shadowpho/SmartBattery/pSpice/DESIGN1.png

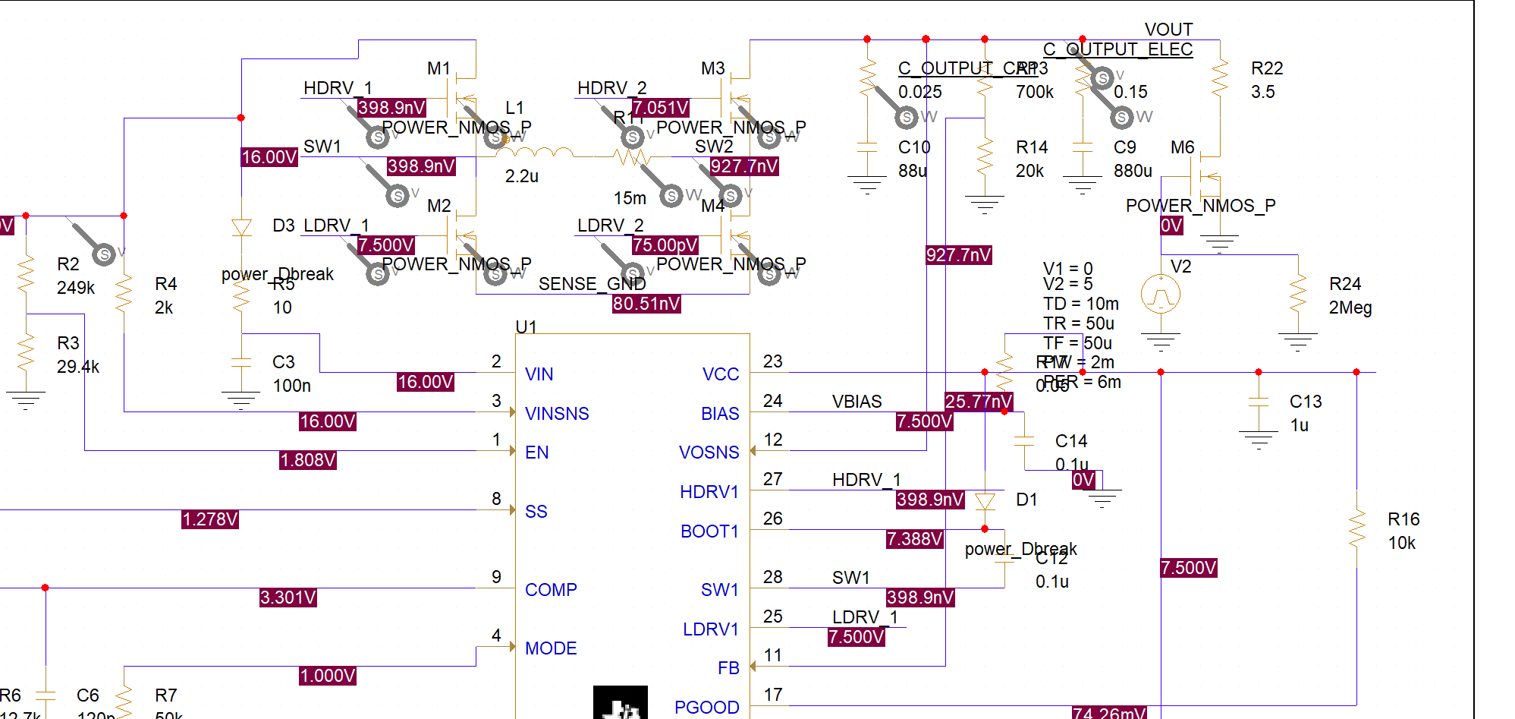
pSpice/DESIGN1.png
