shadowpho/SmartBattery/Cost_JLC3.xlsx

Comment | Designator | Footprint | LCSC
0.1uF 6.3v | C1,C6,C34 | lc_lib:0402_C | C1525
10u | C2,C3,C4,C7,C8,C9,C10,C11,C65,C66,C82,C83,C84,C85,C103,C112,C113 | lc_lib:0805_C | C15850
DNP | C12 | lc_lib:0402_C
1uF 25v | C13,C86,C97,C98,C99,C100,C101,C102,C106,C107,C108,C109,C110,C111,C114,C115 | lc_lib:0402_C | C52923
220u | C16,C40,C89 | Capacitor_SMD:C_Elec_8x10.2 | C311611
0.1u 6.3v | C18,C19,C20,C21,C23,C24,C25,C26,C32,C53,C54,C57,C59,C61,C62,C69,C72,C73,C74,C75 | lc_lib:0402_C | C1525
0.1u 20v | C27,C28 | lc_lib:0402_C | C1525
0.1u 50v | C30,C33 | lc_lib:0402_C | C1525
0.1uF | C31 | lc_lib:0402_C | C1525
2.2u 50v | C29,C35 | lc_lib:0805_C | C49217
33nF | C14,C15,C17,C38 | lc_lib:0402_C | C1585
33pF | C39 | lc_lib:0402_C | C1562
0.1uF 25v | C22,C43,C46 | lc_lib:0402_C | C1525
22u | C44,C55,C56,C63,C64,C79,C80,C81,C87,C88,C90,C91,C92,C93,C94 | lc_lib:0805_C | C45783
150pF | C37,C41,C42,C45,C51,C95,C96,C104,C105 | lc_lib:0402_C | C1527
1.5nF | C47 | lc_lib:0402_C
680pF | C48 | lc_lib:0603_C
15pF | C49 | lc_lib:0402_C | C1548
0.1u | C5 | lc_lib:0402_C
1uF 16v | C50,C52 | lc_lib:0402_C
15 pF 0402 | C58,C60 | lc_lib:0402_C | C1548
0.1u 25v | C67,C76 | lc_lib:0402_C
12pF 0402 | C68,C71 | lc_lib:0402_C | C1547
2.2u 6.3v | C36,C70 | lc_lib:0805_C
8.2nF | C77 | lc_lib:0603_C
220pF | C78 | lc_lib:0402_C
ESDA6V8AV6 | D1,D10 | Package_TO_SOT_SMD:SOT-563 | C134180 (https://lcsc.com/product-detail/Diodes-ESD_ESDA6V8AV6-6-TR_C134180.html/?href=jlc-SMT)
B5817W-5819W | D8,D9,D12,D13,D14 | lc_lib:SOD-123 | C179719
PESD24VS1UB-N | D5,D11,D15 | lc_lib:SOD-523 | C316036 (https://lcsc.com/product-detail/Diodes-ESD_Bourne-Semicon-Shenzhen-PESD24VS1UB-N_C316036.html/?href=jlc-SMT)
LED | D2,D3,D4,D6,D7 | Diode_THT:D_DO-15_P3.81mm_Vertical_AnodeUp
Fuse_Small | F1,F2,F3,F4,F5,F6,F7,F8 | lc_lib:1206 | C312012
Ferrite_Bead_Small | FB1 | lc_lib:0603_L | C13415
Conn_01x02_Female | J12
Conn_01x04_Male | J13
Conn_01x01_Female | J14
USB_C_Receptacle_USB2.0 | J1,J15 | Connector_USB:USB_C_Receptacle_Amphenol_12401548E4-2A
Conn_01x03_Female | J16,J17,J18
ST-USB-003A | J2 | Connector_USB:USB3_A_Plug_Wuerth_692112030100_Horizontal
Barrel_Jack_MountingPin | J3 | Connector_BarrelJack:BarrelJack_Horizontal
JST 2P-1.0 | J4,J5,J6,J7,J8,J9,J10,J11 | Connector_JST:JST_SH_SM02B-SRSS-TB_1x02-1MP_P1.00mm_Horizontal
MWSA1004-2R2MT | L1 | SmartBattery:L_10.3x11.5_H4 | C149550
MWSA0603-2R2MT | L2 | SmartBattery:L_10.3x11.5_H4 | C112126 (https://lcsc.com/product-detail/Power-Inductors_Sunlord-MWSA0603-2R2MT_C112126.html/?href=jlc-SMT)
6.8uH 47mO SWPA6028S6R8MT | L3 | Inductor_SMD:L_Taiyo-Yuden_NR-60xx | C42261 (https://lcsc.com/product-detail/Power-Inductors_Sunlord-SWPA6028S6R8MT_C42261.html/?href=jlc-SMT)
2n7002K | Q2,Q7,Q14,Q21,Q25 | Package_TO_SOT_SMD:SOT-23 | C8545
VBA2625 | Q1,Q15,Q16,Q17,Q18,Q19,Q20,Q23,Q24,Q26,Q27 | SmartBattery:SOIC127P600X175-8N | C416236 (https://lcsc.com/product-detail/MOSFET_VBsemi-Elec-VBA2625_C416236.html/?href=jlc-SMT)
AO3401A | Q22 | lc_lib:SOT-23(SOT-23-3) | C15127
AON7400A | Q3,Q4,Q5,Q6,Q8,Q9,Q10,Q11,Q12,Q13 | lc_lib:QFN-8_3X3X065P | C85734
0.01 | R1,R60 | lc_lib:2512_R | C127692
1 mOhm | R7,R8,R10 | lc_lib:1206_R | C17927
100 | R11,R13,R14,R15,R21,R25,R26 | lc_lib:0402_R | C25076
51k | R16,R51 | lc_lib:0402_R | C25794
10Meg | R18 | lc_lib:0402_R | C26082
5.1k | R17,R22,R24,R27,R31,R32,R66,R67,R68,R70,R71,R78,R79,R80,R82 | lc_lib:0402_R | C25905
0.001 | R23 | Resistor_SMD:R_1206_3216Metric | C17927
10M | R29 | lc_lib:0402_R
27k | R34 | lc_lib:0603_R
110k | R35 | lc_lib:0603_R
4.7 | R2,R36 | lc_lib:0402_R
0 | R20,R33,R37,R38,R39,R42,R43,R44,R49,R54,R55,R64,R77 | lc_lib:0402_R | C17168
40.2k | R40 | lc_lib:0603_R
10k | R28,R30,R41 | lc_lib:0402_R
1 | R45 | lc_lib:0402_R
10 | R46,R47,R48 | lc_lib:0402_R
20k | R50 | lc_lib:0402_R
15k | R52 | lc_lib:0402_R
110k | R56,R59 | lc_lib:0402_R
DNP | R19,R53,R57,R58 | lc_lib:0402_R
1k | R3,R4,R5,R6,R12 | lc_lib:0402_R | C11702
?? | R61,R74 | lc_lib:0402_R
100k | R62,R63,R65,R69,R72,R73,R75,R76,R81,R83,R84,R85 | lc_lib:0402_R | C25741
33k | R9 | lc_lib:0402_R
SW_Push | SW1,SW2 | lc_lib:0402_R
NCP18WF104F03 | TH1 | Resistor_SMD:R_0805_2012Metric
NXRT15WB473FA1B030 | TH2,TH3,TH4,TH5 | Diode_THT:D_A-405_P2.54mm_Vertical_AnodeUp
TestPoint | TP1,TP2,TP3,TP4,TP5,TP6,TP7,TP8,TP9,TP10,TP11,TP12,TP13,TP14,TP15,TP16,TP17,TP18,TP19,TP20,TP21,TP22,TP23,TP24,TP25,TP26,TP27,TP28,TP29,TP30,TP31,TP32,TP33,TP34,TP35,TP36,TP37,TP38,TP39,TP40,TP41,TP42,TP43,TP44,TP45 | TestPoint:TestPoint_Pad_D2.0mm
BQ25703ARSNR | U1 | lc_lib:VQFN-32_4X4X04P | C188229 (https://lcsc.com/product-detail/PMIC-Battery-Management_TI_BQ25703ARSNR_BQ25703ARSNR_C188229.html/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)
ESP32-WROOM-32U | U10 | RF_Module:ESP32-WROOM-32U | C328062
STUSB4500 | U11 | Package_DFN_QFN:QFN-24-1EP_4x4mm_P0.5mm_EP2.7x2.6mm | NONE
STUSB4700 | U12 | lc_lib:VQFN-32_4X4X04P | NONE
TPS2511DGNR | U13 | SmartBattery:SOP65P490X110-9N | C68648
HT7533-1 | U14 | lc_lib:SOT-89(SOT-89-3) | C14289
BQ294706DSGR | U2 | Package_SON:WSON-8-1EP_2x2mm_P0.5mm_EP0.9x1.6mm | C216211
ITV4030 | U3 | SmartBattery:ITV4030
BQ40Z50 | U4 | Package_DFN_QFN:QFN-32-1EP_4x4mm_P0.4mm_EP2.65x2.65mm
LM5175PWPR | U5 | SmartBattery:IC_TPS61196PWPRQ1 | C113356
STM32F730R8T6 | U6 | lc_lib:TQFP-64_10X10X05P | C478453
W25Q128JVSIQ | U7 | lc_lib:SOP-8_208MIL | C97521
LMR14030SDDAR | U8 | SmartBattery:NOPB | C182078
FS35ND01G-S1Y2QWFI000 | U9 | SmartBattery:WSON8_8x6mm | C719495
Q13FC1350000400 | Y1 | Crystal:Crystal_SMD_3215-2Pin_3.2x1.5mm | C32346
Crystal_GND24 | Y2 | Crystal:Crystal_SMD_3225-4Pin_3.2x2.5mm | C9006
