shadowpho/SmartBattery/Cost_JLC.xlsx

Comment | Designator | Footprint | LCSC Part #（optional）
1uF 16v | C1, C34, C35 | 0402_C | C52923
10u | C2, C8, C10, C11, C49, C50 | 0805_C | C15850
0.1u | C3, C5, C6 | 0402_C | C1525
22u | C4, C7, C9, C12, C13, C14, C15, C44 | 0805_C | C45783
220u | C16, C17 | ECAP-8x10 | C311611
0.1u 6.3v | C18, C19, C20, C21, C23, C24, C25, C26, C32 | 0402_C | C1525
0.1uF 25v | C22 | 0603_C | C14663
0.1u 20v | C27, C28 | 0402_C | C1525
2.2u 50v | C29 | 805 | C49217
0.1u 50v | C30, C33 | 0603_C | C14663
0.1uF | C31 | 0402_C | C1525
1uF 25v | C37, C43, C48 | 0402_C | C52923
0.1uF 25v | C38, C41, C52 | 0402_C | C1525
0.1uF | C39, C47 | 0402_C | C1525
0.01uF | C42 | 0402_C
2.2uF 25v | C45 | 805 | C49217
CD1206-S01575 | D1, D9 | SOD-123 | C8598
Fuse_Small | F1, F2, F3, F4, F5, F6, F7, F8 | SMD | C312012 | C187564 (https://lcsc.com/product-detail/Surface-Mount-Fuses_Littelfuse-0458010-DR_C187564.html/?href=jlc-SMT)
MWSA0603-2R2MT | L1, L2 | SMD | C385252
4.7uH | L3
AO4407A | Q1
2n7002K | Q2, Q7 | SOT-23-3 | C8545
AO4468 | Q3, Q4, Q5, Q6, Q8, Q9, Q10, Q11, Q12, Q13 | SOP-8_3.9x4.9x1.27P | C87410
0.01 | R1, R2 | 2512_R | C127692
1k | R3, R4, R5, R6, R12 | 0402_R | C11702
1 mOhm | R7, R8, R10 | 1206_R | C17927
100 | R11, R13, R14, R15, R21, R25, R26 | 0402_R | C25076
51k | R16 | 0402_R | C25794
5.1k | R17, R22, R24, R27, R31, R32 | 0402_R | C25905
10Meg | R9, R18, R29, R34 | 0402_R | C26082
0 | R20 | 0402_R | C17168
1M | R39 | 0402_R | C26083
470k | R40 | 0402_R | C25790
100k | R41 | 0402_R | C25741
0.001 | R23
4.7 | R42, R48
4.02k | R43, R44
10 | R45
SW_Push | SW1, SW2
NCP18WF104F03 | TH1
NXRT15WB473FA1B030 | TH2, TH3, TH4, TH5
bq2477x | U1
BQ294706DSGR | U2
ITV4030 | U3
BQ40Z50 | U4
LM5175PWPR | U5
ESP32-WROOM-32U | U6
ATSAMD21G18A-MU | U7
TPS54202HDDCR | U8
