shadowpho/SmartBattery/Symbols/DM3AT-SF-PEJM5.step

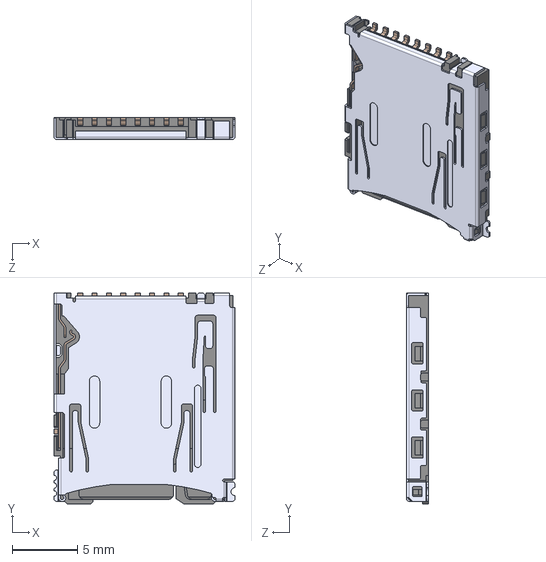
[picture p2: CAD file, 2021-01-27]
Symbols/DM3AT-SF-PEJM5.step
13.8 x 16.2 x 1.68 mm
