shadowpho/SmartBattery/Symbols/JACK-C-PC-10A-RA_R_.step

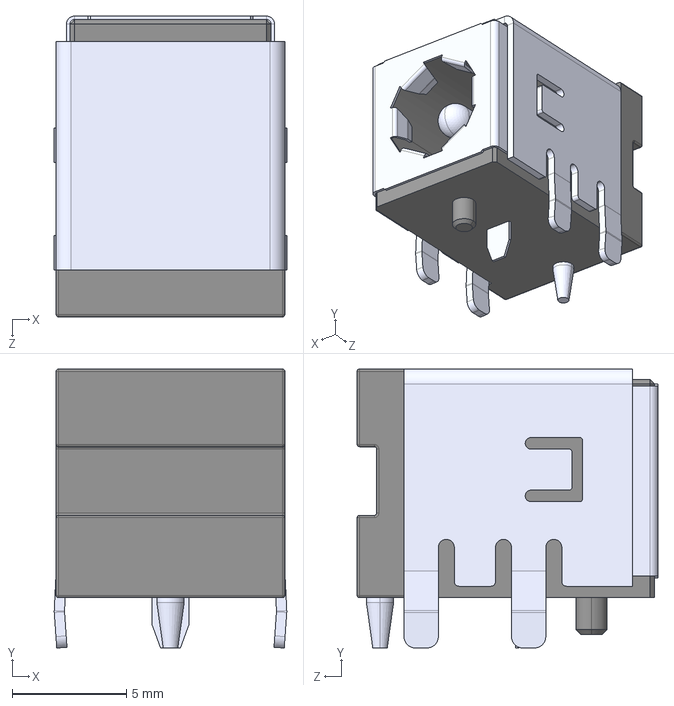
[picture p3: CAD file, 2021-01-17]
Symbols/JACK-C-PC-10A-RA_R_.step
10.2 x 12.2 x 13.2 mm
