shadowpho/SmartBattery/Symbols/TPS2511DGNR.step

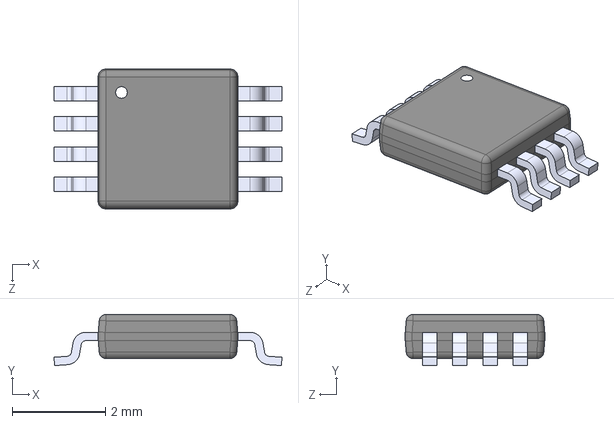
[picture p4: CAD file, 2021-01-04]
Symbols/TPS2511DGNR.step
4.90 x 1.10 x 3.00 mm
