shadowpho/SmartBattery/Symbols/STM32F730R8T6.step

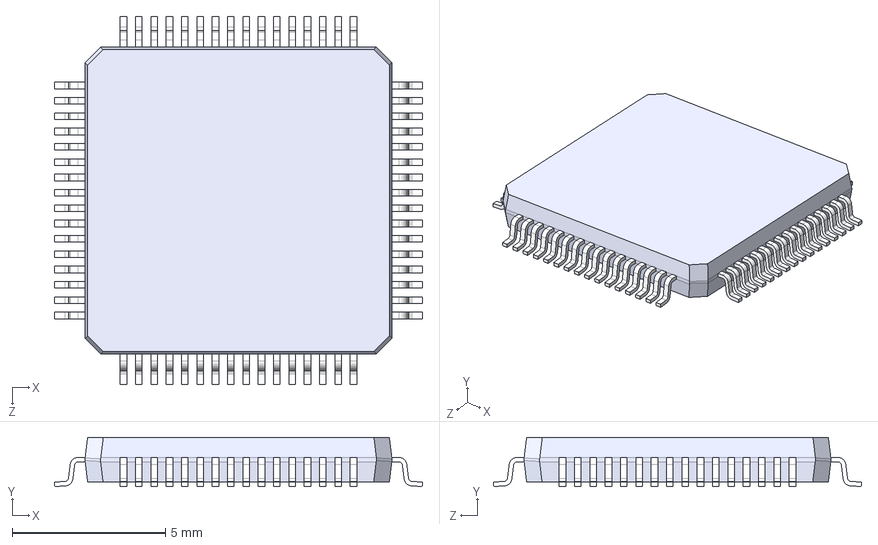
[picture p5: CAD file, 2020-12-30]
Symbols/STM32F730R8T6.step
12.0 x 1.60 x 12.0 mm
