shadowpho/SmartBattery/Symbols/LMR14030SDDAR.STEP

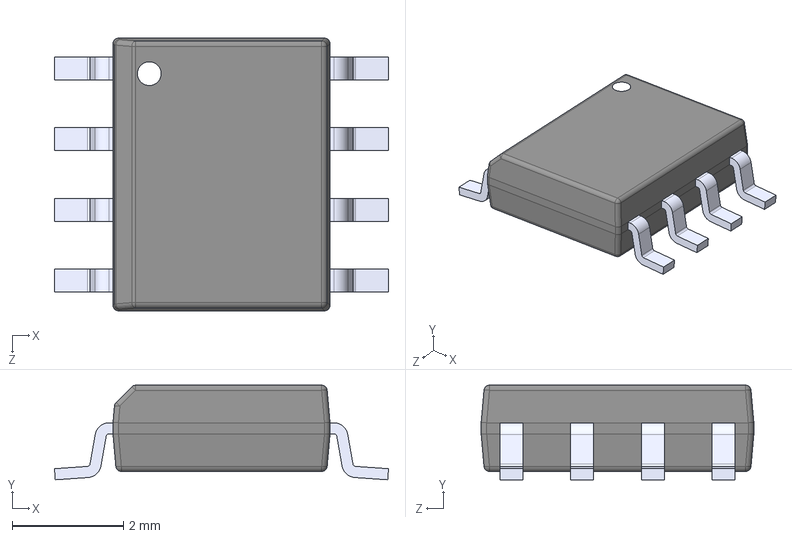
[picture p6: CAD file, 2020-12-30]
Symbols/LMR14030SDDAR.STEP
6.00 x 1.70 x 4.90 mm
