shadowpho/SmartBattery/Symbols/TPS54202HDDCR.step

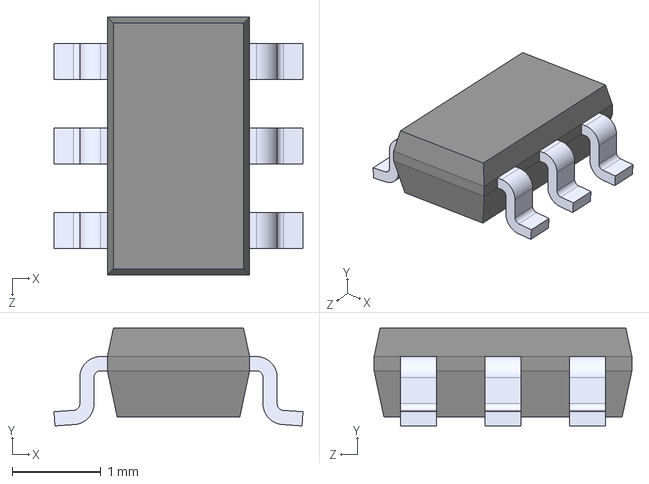
[picture p7: CAD file, 2020-12-25]
Symbols/TPS54202HDDCR.step
2.80 x 1.10 x 2.90 mm
