shadowpho/SmartBattery/(list of files, drawings)

Other design files:
pSpice/DESIGN1.DSN
pSpice/Design1.opj
