shadowpho/SmartBattery/SmartBattery.kicad_pcb

## KiCad design SmartBattery.kicad_pcb (2021-01-29)

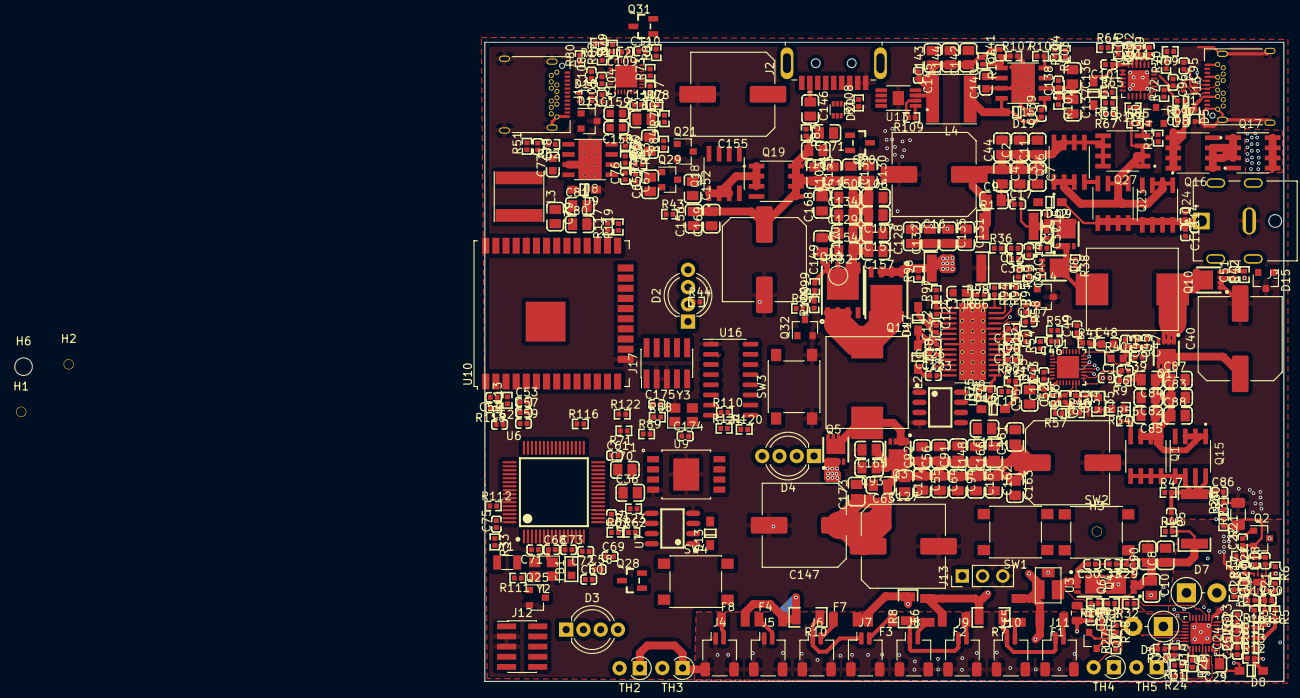
[picture p8: board SmartBattery.kicad_pcb from above]

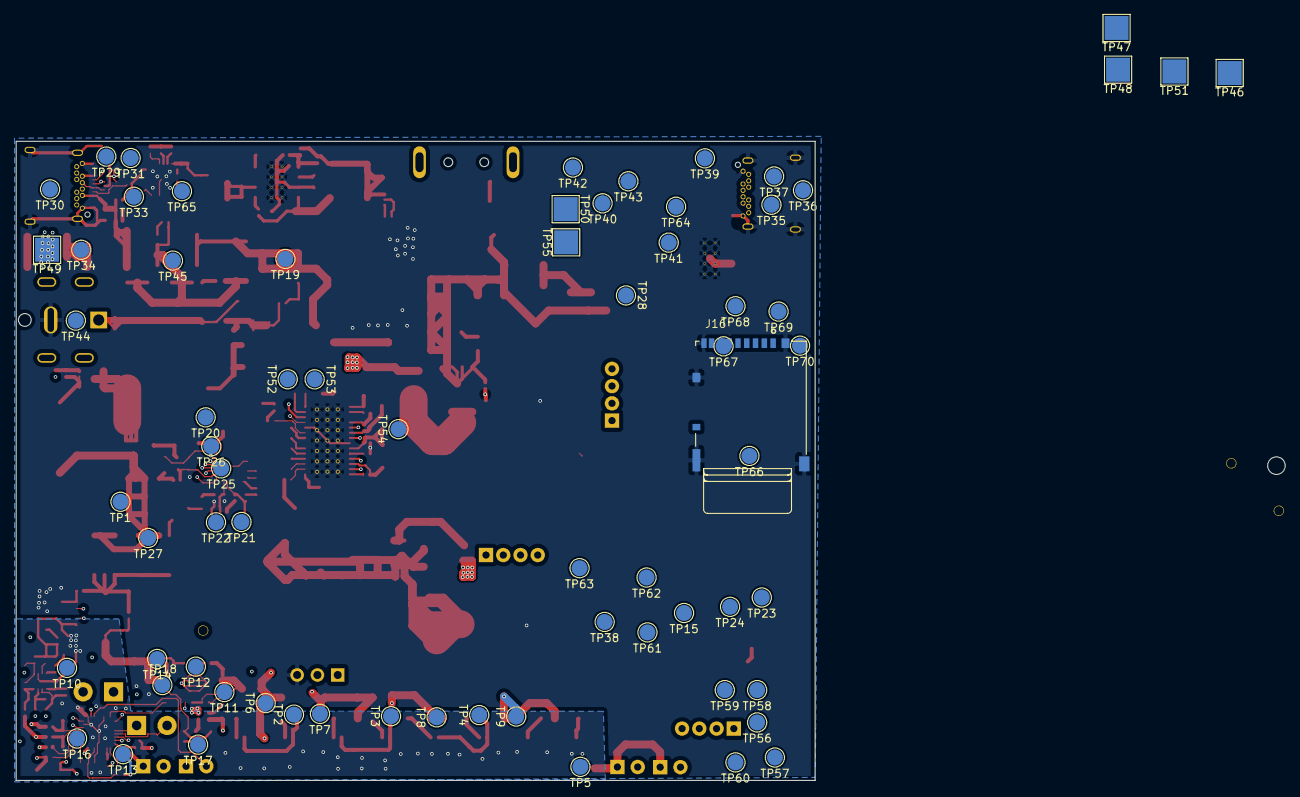
[picture p9: board SmartBattery.kicad_pcb from below]

Board: 4 copper layers, 100.0 x 80.0 mm, 481 parts (70 on the bottom side), 267 nets.

Parts:
C1, C6, C34: 0.1uF 6.3v; 0402_C
C2, C3, C4, C7, C8, C9, C10, C11, C65, C66, C82, C83, C84, C85, C136, C137: 10u; 0805_C
C5: 0.1u; 0402_C
C12: DNP; 0402_C
C13, C86, C97, C98, C99, C100, C101, C102, C108, C109, C110, C111: 1uF 25v; 0402_C
C14, C15, C17, C38, C124: 33nF; 0402_C
C16, C40, C89, C127, C147, C149, C155: 470u; C_Elec_10x10.2
C18, C19, C20, C21, C23, C24, C25, C26, C32, C53, C54, C57, C59, C61, C62, C69, C72, C73, C74, C75: 0.1u 6.3v; 0402_C
C22, C43, C46, C145: 0.1uF 25v; 0402_C
C27, C28: 0.1u 20v; 0402_C
C29, C35: 2.2u 50v; 0805_C
C30, C33: 0.1u 50v; 0402_C
C31, C122, C123: 0.1uF; 0402_C
C36, C70, C112: 2.2u 6.3v; 0805_C
C37, C41, C42, C45, C51, C95, C96, C104, C105, C117: 150pF; 0402_C
C39: 33pF; 0402_C
C44, C55, C56, C63, C64, C79, C80, C81, C87, C88, C90, C91, C92, C93, C94, C142, C143, C144, C146, C148, C161, C162, C163, C164, C165, C166, C172, C173: 22u; 0805_C
C47: 1.5nF; 0402_C
C48: 680pF; 0603_C
C49: 15pF; 0402_C
C50, C52: 1uF 16v; 0402_C
C58, C60: 15 pF 0402; 0402_C
C67, C76, C138, C139: 0.1u 25v; 0402_C
C68, C71, C174, C175: 12pF 0402; 0402_C
C77, C140: 8.2nF; 0603_C
C78, C141: 220pF; 0402_C
C103, C106, C107, C128, C129, C130, C131, C132, C133, C134, C135, C150, C151, C152, C153, C154, C156, C157, C160, C167, C168, C169, C170, C171: 10u 50v; 0805_C
C114, C115, C118, C125, C126: 1uF 50v; 0402_C
C116: 4.7n; 0603_C
C119: 47n; 0402_C
C120: 33n; 0402_C
C121: 68p; 0402_C
C158, C159: 1uF 50v; 0603_C
D1, D10, D20: ESDA6V8AV6; SOT-563
D2, D3, D4: LED_BARG; LED_D5.0mm-4_RGB_Wide_Pins
D5: PESD24VS1UB-N; SOD-523
D6, D7: LED; D_DO-15_P3.81mm_Vertical_AnodeUp
D8, D9, D12, D13, D14, D16, D17, D18, D19: B5817W-5819W; SOD-123
D11, D15: NUP3105LT1G; SOT-23
F1, F2, F3, F4, F5, F6, F7, F8: Fuse_Small; 1206
FB1: Ferrite_Bead_Small; 0603_L
H1, H2, H3: MountingHole; MountingHole_1.152mm_JLPCB
H4, H5, H6: MountingHole; MountingHole_2.2mm_M2
J1, J15: USB_C_Receptacle_USB2.0; USB_C_Receptacle_Amphenol_12401548E4-2A
J2: ST-USB-003A; USB3_A_Plug_Wuerth_692112030100_Horizontal
J3: JACK-C-PC-10A-RA(R); GLOBTECK_JACK-C-PC-10A-RA(R)
J4, J5, J6, J7, J8, J9, J10, J11: JST 2P-1.0; JST_SH_SM02B-SRSS-TB_1x02-1MP_P1.00mm_Horizontal
J12, J17: Conn_02x05_Odd_Even; PinHeader_2x05_P1.27mm_Vertical_SMD
J13: Conn_01x03_Male; PinHeader_1x03_P2.54mm_Vertical
J16: DM3AT-SF-PEJM5; HRS_DM3AT-SF-PEJM5
L1, L2: MWSA1004-2R2MT; L_10.3x11.5_H4
L3, L4: 6.8uH 47mO SWPA6028S6R8MT; L_Taiyo-Yuden_NR-60xx
Q1, Q15, Q16, Q17, Q18, Q19, Q23, Q24, Q26, Q27: VBA2625; SOIC127P600X175-8N
Q2, Q7, Q14, Q25: 2n7002K; SOT-23
Q3, Q4, Q5, Q6, Q8, Q9, Q10, Q11: AON7400A; SON-8_3.3X3.3MM
Q12, Q13: BSC067N06LS3; DFN-8_5X6MM
Q20, Q28: LBSS84LT1G; SOT-23(SOT-23-3)
Q21, Q29, Q30, Q32: 2N7002; SOT-23
Q31: AO3401A; SOT-23(SOT-23-3)
R1, R60, R98: 0.01; 2512_R
R2, R36: 4.7; 0402_R
R3, R4, R5, R6, R12, R43, R114: 1k; 0402_R
R7, R8, R10: 1 mOhm; 1206_R
R9: 33k; 0402_R
R11, R13, R14, R15, R21, R25, R26, R117, R118, R119: 100; 0402_R
R16, R51: 51k; 0402_R
R17, R22, R24, R27, R31, R32, R66, R67, R68, R70, R71, R78, R79, R80, R82: 5.1k; 0402_R
R18: 10Meg; 0402_R
R19, R53, R57, R58: DNP; 0402_R
R20, R33, R37, R38, R39, R42, R49, R54, R55, R64, R77, R93, R94, R95, R102, R103: 0; 0402_R
R23: 0.001; R_1206_3216Metric
R28, R30, R41, R86, R101, R115: 10k; 0402_R
R29: 10M; 0402_R
R34: 27k; 0603_R
R35: 110k; 0603_R
R40: 40.2k; 0603_R
R44, R62, R63, R65, R69, R72, R73, R75, R76, R81, R83, R84, R85, R88, R89, R108, R110, R111, R112, R113, R116, R120, R121, R122: 100k; 0402_R
R45, R96, R97: 1; 0402_R
R46, R47, R48: 10; 0402_R
R50, R100, R105: 20k; 0402_R
R52, R107: 15k; 0402_R
R56, R59: 110k; 0402_R
R61, R74, R87, R91, R104: ??; 0402_R
R90: 68.1k; 0402_R
R92: 93.1k; 0402_R
R99: 280k; 0402_R
R106: ???; 0402_R
R109: 22.1k; 0402_R
R123: 50k; 0402_R
SW1, SW2, SW3, SW4: SW_Push; SW_Push_1P1T_NO_6x6mm_H9.5mm
TH1: NCP18WF104F03; R_0805_2012Metric
TH2, TH3, TH4, TH5: NXRT15WB473FA1B030; D_A-405_P2.54mm_Vertical_AnodeUp
TP1, TP2, TP3, TP4, TP5, TP6, TP7, TP8, TP9, TP10, TP11, TP12, TP13, TP14, TP15, TP16, TP17, TP18, TP19, TP20, TP21, TP22, TP23, TP24, TP25, TP26, TP27, TP28, TP29, TP30, TP31, TP32, TP33, TP34, TP35, TP36, TP37, TP38, TP39, TP40, TP41, TP42, TP43, TP44, TP45, TP52, TP53, TP54, TP56, TP57, TP58, TP59, TP60, TP61, TP62, TP63, TP64, TP65, TP66, TP67, TP68, TP69, TP70: TestPoint; TestPoint_Pad_D2.0mm
TP46, TP47, TP48, TP49, TP50, TP51, TP55: TestPoint_Flag; TestPoint_Pad_3.0x3.0mm
U1: BQ25703ARSNR; VQFN-32_4X4X04P
U2: BQ294706DSGR; WSON-8-1EP_2x2mm_P0.5mm_EP0.9x1.6mm
U3: ITV4030
U4: BQ40Z50; QFN-32-1EP_4x4mm_P0.4mm_EP2.65x2.65mm
U5: LM5175PWPR; IC_TPS61196PWPRQ1
U6: STM32F730R8T6; TQFP-64_10X10X05P
U7: LY68L6400SLIT; SOP-8_150MIL
U8, U15: LMR14030SDDAR; NOPB
U9: FS35ND01G-S1Y2QWFI000; WSON8_8x6mm
U10: ESP32-WROOM-32U
U11: STUSB4500; QFN-24-1EP_4x4mm_P0.5mm_EP2.7x2.6mm
U12: STUSB4700; VQFN-32_4X4X04P
U13: TPS2511DGNR; SOP65P490X110-9N
U14: MCP6002-xMC; SOIC-8_150MIL
U16: CH340G; SOIC-16_3.9x9.9mm_P1.27mm
Y1: Q13FC1350000400; Crystal_SMD_3215-2Pin_3.2x1.5mm
Y2: 24MHz; Crystal_SMD_3225-4Pin_3.2x2.5mm
Y3: 12MHz; Crystal_SMD_3225-4Pin_3.2x2.5mm

Connections:
+3.3VP: C36.2, C53.1, C54.1, C57.1, C59.1, C61.1, C62.1, C74.1, C75.1, C78.2, C79.1, C80.1, C81.1, C112.2, D3.2, D4.2, FB1.1, J12.1, J16.4, J17.1, L3.2, R33.1, R51.1, R111.2, SW4.2, U6.19, U6.32, U6.48, U6.64, U7.8, U9.8, U10.2, U14.8
/5V_ENABLE: R108.2, U13.5
/ADAPTER_IN: C2.1, C3.1, C4.1, C7.1, C9.1, C11.1, C16.1, C44.1, Q17.5, Q17.6, Q17.7, Q17.8, Q26.5, Q26.6, Q26.7, Q26.8, Q27.5, Q27.6, Q27.7, Q27.8, R1.1, R36.1, TP19.1, TP49.1
/BARREL_RAW: C114.2, C115.1, D12.2, D15.1, D15.2, J3.1, Q23.5, Q23.6, Q23.7, Q23.8, Q24.5, Q24.6, Q24.7, Q24.8, R110.1, TP44.1
/BATT_INT_N: TP15.1, U4.15, U6.57
/BATT_PACK_P: C5.2, C8.1, C10.1, C33.1, C90.1, Q6.1, Q6.2, Q6.3, Q7.2, R28.2, R29.2, R48.2, R60.2, TP18.1
/BATT_SHUTDOWN_N: R32.2, U6.62
/BATT_SMB_C: J13.2, TP16.1, U4.19, U6.61
/BATT_SMB_D: J13.1, TP17.1, U4.18, U6.59
/BYPASS_VSYS: D12.1, D13.1, D14.1, R37.2, R102.2
/Barrel_Jack_Input/BARREL_ENABLE: Q25.1, R116.2
/CURRENT_TRIP: U14.1, U14.6
/Charger/REGN: C35.2, R46.1, R56.1, R59.1, U1.28
/Charger/VSYS: C40.1, C55.1, C56.1, C63.1, C64.1, C82.1, C83.1, C84.1, C85.1, C87.1, C88.1, C89.1, C91.1, C92.1, C93.1, C94.1, C127.1, C147.1, C148.1, C161.1, C162.1, C163.1, C164.1, C165.1, C166.1, C172.1, C173.1, D13.2, D16.2, Q1.1, Q1.2, Q1.3, Q3.5, Q3.6, Q3.7, Q3.8, Q11.5, Q11.6, Q11.7, Q11.8, Q15.1, Q15.2, Q15.3, TP1.1, TP28.1, TP51.1, U1.22, U5.3
/DAC1: U6.20, U14.3
/DAC2: R123.2, U6.21
/IADP: C34.1, R35.1, U1.8, U6.11
/IBAT: C1.1, U1.9, U6.24
/INPUT_TYPEC_RAW: C97.2, C98.1, C101.1, D5.2, D14.2, J15.A4, J15.A9, J15.B4, J15.B9, Q16.5, Q16.6, Q16.7, Q16.8, Q30.3, R61.1, R88.1, R115.2, TP31.1, U11.24
/INPUT_USB_DM: D1.1, D1.3, J15.A6, J15.A7, J15.B6, J15.B7
/MCU/ADC1_IN10: R88.2, R89.1, U6.8
/MCU/ADC1_IN11: R110.2, R120.1, U6.9
/MCU/ADC1_IN12: R121.2, R122.1, U6.10
/MCU/BOOT: R112.2, SW4.1, U6.60
/MCU/DET: J16.SWA, TP66.1, U10.8
/MCU/ESP32_SERIAL_BL: R119.1, U10.25
/MCU/ESP32_UART_RX: U6.42, U10.34
/MCU/ESP32_UART_TX: U6.43, U10.35
/MCU/ESP32_WAKE: R117.1, U10.26
/MCU/GPIO_ENABLE_ESP32: J17.10, R113.2, R118.1, U10.3
/MCU/NRST: J12.10, R111.1, SW3.1, TP56.1, TP60.1, U6.7
/MCU/QUADSPI_BK1_IO0: U6.40, U7.5
/MCU/QUADSPI_BK1_IO1: U6.51, U7.2
/MCU/QUADSPI_CLK: U6.27, U7.6
/MCU/QUASPI_BK1_NCS: U6.58, U7.1
/MCU/SPI2_MISO: U6.35, U9.5
/MCU/SPI2_MOSI: U6.36, U9.2
/MCU/SPI2_NSS: U6.33, U9.1
/MCU/SPI2_SCK: U6.34, U9.6
/MCU/SWDCLK: J12.4, TP58.1, U6.49
/MCU/SWDIO: J12.2, TP57.1, U6.46
/MCU/SWO: J12.6, TP59.1, U6.55
/MCU/TCK: J17.4, U10.16
/MCU/TDI: J17.8, U10.14
/MCU/TDO: J17.6, U10.23
/MCU/TMS: J17.2, U10.13
/MCU/UART5_RX: U6.54, U10.28
/MCU/UART5_TX: U6.53, U10.27
/OUTPUT_ALERT_N: R80.1, U12.9
/OUTPUT_ENABLE: R76.1, U5.1, U14.7
/OUTPUT_TYPEC_MCUPWR: Q21.1, Q31.1, R44.2, R77.1, R84.2
/OUTPUT_TYPEC_SCL: R78.1, U12.7
/OUTPUT_TYPEC_SDA: R79.1, U12.8
/OUTPUT_USB_DM: D10.1, D10.3, J1.A6, J1.A7, J1.B6, J1.B7
/OUTPUT_VOLTAGE: C103.1, C106.1, C107.2, C128.1, C129.2, C130.2, C131.2, C132.1, C133.2, C134.2, C135.2, C149.1, C150.2, C151.2, C152.2, C153.2, C154.2, C155.1, C156.2, C157.2, C167.2, C168.2, C169.2, C170.2, C171.2, Q12.0, Q12.5, Q12.6, Q12.7, Q12.8, Q19.5, Q19.6, Q19.7, Q19.8, Q20.2, R83.2, R87.2, R95.1, R99.2, R121.1, TP50.1, TP55.1, U5.12
/OutputStage/HDRV_1: Q3.4, U5.27
/OutputStage/HDRV_2: Q12.4, U5.19
/OutputStage/LDRV_1: Q5.4, U5.25
/OutputStage/LDRV_2: Q13.4, U5.21
/OutputStage/SW1: C123.2, L2.2, Q3.1, Q3.2, Q3.3, Q5.5, Q5.6, Q5.7, Q5.8, U5.28
/OutputStage/SW2: C122.2, L2.1, Q12.1, Q12.2, Q12.3, Q13.0, Q13.5, Q13.6, Q13.7, Q13.8, U5.18
/Output_TYPEA/OUTPUT_CS_N: TP32.1, U13.4
/PSYS: C6.2, R9.2, U1.10, U6.26, U14.2
/Peripheral_3p3v/3p3_SWITCHED_NODE: C76.1, D9.1, L3.1, U8.8
/Peripheral_3p3v/5v0: C141.2, C142.1, C143.1, C144.1, C145.2, L4.2, R106.1, U13.3
/Peripheral_3p3v/5v0_SWITCHED_NODE: C139.1, D19.1, L4.1, U15.8
/Peripheral_3p3v/VSYS_IN_3p3: C65.2, C66.1, C67.1, R37.1, R49.2, U8.2
/Peripheral_3p3v/VSYS_IN_5p0: C136.2, C137.1, C138.1, R102.1, U15.2
/RESET_OVERCURRENT: R75.2, R76.2, U14.5
/Type_C_Output/2v7_local: C109.1, U12.23
/Type_C_Output/LOCAL_PWR: C110.1, R77.2, R78.2, R79.2, R80.2, U12.22
/Type_C_Output/VCONN: C111.1, Q31.3, U12.3
/Type_C_Output/VCONN_VOLTAGE: Q31.2, R44.1
/type_c_input/2v7_local: C100.1, U11.23
/type_c_input/INPUT_TYPEC_ALERT_N: R68.1, U11.19
/type_c_input/INPUT_TYPEC_SCL: R66.1, U11.7
/type_c_input/INPUT_TYPEC_SDA: R67.1, U11.8
/type_c_input/LOCAL_PWR: C102.1, R64.2, R66.2, R67.2, R68.2, U11.22
BAT_VN_0: C18.2, C22.1, C23.2, C27.2, C28.2, C29.2, J4.1, J4.MP, J5.1, J5.MP, J6.MP, J7.MP, J8.MP, J9.MP, J10.MP, J11.MP, Q2.2, R16.1, R19.2, R21.2, R23.1, SW1.2, SW2.2, TH2.1, TH3.1, TH4.1, TH5.1, TP5.1, U2.6, U2.9, U4.7, U4.9, U4.14, U4.29, U4.33
BAT_VN_1: J6.1, J7.1, R10.1, TP4.1
BAT_VN_2: J8.1, J9.1, R8.1, TP3.1
BAT_VN_3: J10.1, J11.1, R7.1, TP2.1
BAT_VP_0: F4.2, F8.2, R6.2, R10.2, R15.2, TP9.1
BAT_VP_1: F3.2, F7.2, R5.2, R8.2, R14.2, TP8.1
BAT_VP_2: F2.2, F6.2, R4.2, R7.2, R13.2, TP7.1
BAT_VP_3: D8.2, F1.2, F5.2, R3.2, R12.2, TP6.1, U3.1
FUSE_HEATER: C22.2, Q2.1, R16.2, R17.2, R31.2, TP10.1
GND: C1.2, C2.2, C3.2, C4.2, C6.1, C7.2, C8.2, C9.2, C10.2, C11.2, C13.1, C14.2, C15.1, C16.2, C17.1, C34.2, C35.1, C36.1, C37.2, C38.1, C39.1, C40.2, C41.1, C42.1, C44.2, C45.1, C47.1, C48.2, C49.2, C50.2, C51.1, C52.2, C53.2, C54.2, C55.2, C56.2, C57.2, C58.2, C59.2, C60.2, C61.2, C62.2, C63.2, C64.2, C65.1, C66.2, C67.2, C68.2, C69.1, C70.2, C71.2, C72.1, C73.1, C74.2, C75.2, C77.1, C79.2, C80.2, C81.2, C82.2, C83.2, C84.2, C85.2, C86.2, C87.2, C88.2, C89.2, C90.2, C91.2, C92.2, C93.2, C94.2, C95.1, C96.1, C97.1, C98.2, C99.2, C100.2, C101.2, C102.2, C103.2, C104.1, C105.1, C106.2, C107.1, C108.2, C109.2, C110.2, C111.2, C112.1, C114.1, C115.2, C116.2, C117.2, C118.1, C119.1, C120.1, C121.2, C125.2, C126.2, C127.2, C128.2, C129.1, C130.1, C131.1, C132.2, C133.1, C134.1, C135.1, C136.1, C137.2, C138.2, C140.1, C142.2, C143.2, C144.2, C145.1, C146.2, C147.2, C148.2, C149.2, C150.1, C151.1, C152.1, C153.1, C154.1, C155.2, C156.1, C157.1, C158.1, C159.2, C160.1, C161.2, C162.2, C163.2, C164.2, C165.2, C166.2, C167.1, C168.1, C169.1, C170.1, C171.1, C172.2, C173.2, C174.2, C175.2, D1.2, D5.1, D9.2, D10.2, D11.3, D15.3, D19.2, D20.2, J1.A1, J1.A12, J1.B1, J1.B12, J1.S1, J2.4, J2.5, J3.2, J12.3, J12.5, J13.3, J15.A1, J15.A12, J15.B1, J15.B12, J15.S1, J16.6, J16.P1, J16.P2, J16.P3, J16.P4, J16.SWB, J17.3, J17.5, Q8.1, Q8.2, Q8.3, Q10.1, Q10.2, Q10.3, Q14.3, Q21.2, Q25.2, Q32.2, R9.1, R23.2, R25.2, R30.1, R34.1, R43.1, R50.1, R52.2, R53.1, R57.1, R58.2, R62.2, R65.1, R71.2, R72.1, R73.1, R75.1, R84.1, R89.2, R90.1, R92.1, R93.1, R94.1, R97.2, R98.1, R100.1, R104.1, R105.1, R107.2, R108.1, R109.1, R112.1, R113.1, R114.1, R116.1, R120.2, R122.2, SW3.2, TP46.1, TP47.1, TP48.1, U1.0, U1.27, U5.10, U5.22, U5.29, U5.30, U5.31, U5.32, U5.33, U5.34, U5.35, U5.36, U5.37, U5.38, U5.39, U5.40, U5.41, U5.42, U5.43, U5.44, U5.45, U5.46, U5.47, U5.48, U5.49, U5.50, U6.12, U6.18, U6.31, U6.47, U6.63, U7.4, U8.7, U8.9, U8.10, U8.11, U8.12, U8.13, U8.14, U8.15, U8.16, U8.17, U9.4, U9.9, U10.1, U10.15, U10.38, U11.10, U11.25, U12.1, U12.5, U12.10, U12.24, U13.1, U13.9, U14.4, U15.7, U15.9, U15.10, U15.11, U15.12, U15.13, U15.14, U15.15, U15.16, U15.17, U16.1, Y2.2, Y2.4, Y3.2, Y3.4
unnamed: C5.1, C86.1, Q1.5, Q1.6, Q1.7, Q1.8, Q15.5, Q15.6, Q15.7, Q15.8, R47.2, R60.1
unnamed: C12.1, C14.1, R2.2, TP21.1, U1.2
unnamed: C12.2, C38.2, R36.2, TP22.1, U1.3
unnamed: C13.2, R45.1, U1.1
unnamed: C15.2, C17.2, C37.1, Q9.5, Q9.6, Q9.7, Q9.8, R1.2, R2.1, R45.2
unnamed: C18.1, C21.2, R6.1, U2.5
unnamed: C19.1, R3.1, R11.2, U2.2
unnamed: C19.2, C20.1, R4.1, U2.3
unnamed: C20.2, C21.1, R5.1, U2.4
unnamed: C23.1, C26.2, R15.1, U4.5
unnamed: C24.1, R12.1, U4.2
unnamed: C24.2, C25.1, R13.1, U4.3
unnamed: C25.2, C26.1, R14.1, U4.4
unnamed: C27.1, U2.7
unnamed: C28.1, R11.1, U2.1
unnamed: C29.1, U4.1
unnamed: C30.1, C33.2
unnamed: C30.2, Q4.1, Q4.2, Q4.3, R18.2, U3.3
unnamed: C31.1, TH1.1, U4.23
unnamed: C31.2, D8.1, R20.2, TH1.2, U4.32
unnamed: C32.1, R25.1, U4.8
unnamed: C32.2, R21.1, U4.6
unnamed: C39.2, R40.1, U1.16
unnamed: C41.2, Q8.4, R39.2
unnamed: C42.2, C45.2, C47.2, R40.2
unnamed: C43.1, L1.2, Q8.5, Q8.6, Q8.7, Q8.8, Q9.1, Q9.2, Q9.3, TP20.1, U1.32
unnamed: C43.2, U1.30
unnamed: C46.1, L1.1, Q10.5, Q10.6, Q10.7, Q10.8, Q11.1, Q11.2, Q11.3, U1.23
unnamed: C46.2, U1.25
unnamed: C48.1, R41.2
unnamed: C49.1, R41.1, U1.17
unnamed: C50.1, R46.2, U1.7
unnamed: C51.2, Q10.4, R42.2
unnamed: C52.1, R56.2, R57.2, U1.6
unnamed: C58.1, U6.3, Y1.2
unnamed: C60.1, U6.4, Y1.1
unnamed: C68.1, U6.6, Y2.1
unnamed: C69.2, C70.1, U6.30
unnamed: C71.1, U6.5, Y2.3
unnamed: C72.2, C73.2, FB1.2, TP24.1, U6.13
unnamed: C76.2, U8.1
unnamed: C77.2, U8.6
unnamed: C78.1, R51.2, R52.1, U8.5
unnamed: C95.2, D1.4, J15.B5, U11.4, U11.5
unnamed: C96.2, D1.5, J15.A5, U11.1, U11.2
unnamed: C99.1, U11.21
unnamed: C104.2, D10.4, J1.B5, U12.4
unnamed: C105.2, D10.5, J1.A5, U12.2
unnamed: C108.1, U12.21
unnamed: C116.1, R86.2
unnamed: C117.1, R86.1, U5.9
unnamed: C118.2, R91.1, U5.2
unnamed: C119.2, U5.5
unnamed: C120.2, U5.8
unnamed: C121.1, U5.7
unnamed: C122.1, D17.1, U5.20
unnamed: C123.1, D18.1, U5.26
unnamed: C124.1, R97.1, U5.15
unnamed: C124.2, R96.1, U5.16
unnamed: C125.1, R95.2, U5.24
unnamed: C126.1, D17.2, D18.2, TP54.1, U5.23
unnamed: C139.2, U15.1
unnamed: C140.2, U15.6
unnamed: C141.1, R106.2, R107.1, U15.5
unnamed: C146.1, D20.1, J2.1, U13.8
unnamed: C158.2, C159.1, C160.2, D11.1, D11.2, J1.A4, J1.A9, J1.B4, J1.B9, Q18.5, Q18.6, Q18.7, Q18.8, Q29.3, R74.1, R101.2, TP37.1
unnamed: C174.1, U16.7, Y3.1
unnamed: C175.1, U16.8, Y3.3
unnamed: D3.1, U10.12
unnamed: D3.3, U10.10
unnamed: D3.4, U10.11
unnamed: D4.1, U10.7
unnamed: D4.3, U10.9
unnamed: D4.4, U10.6
unnamed: D6.1, U4.20
unnamed: D6.2, D7.1, U4.21
unnamed: D7.2, U4.22
unnamed: D16.1, R91.2
unnamed: D20.3, J2.3, U13.6
unnamed: D20.6, J2.2, U13.7
unnamed: F1.1, J11.2
unnamed: F2.1, J9.2
unnamed: F3.1, J7.2
unnamed: F4.1, J5.2
unnamed: F5.1, J10.2
unnamed: F6.1, J8.2
unnamed: F7.1, J6.2
unnamed: F8.1, J4.2
unnamed: J1.A8, TP35.1
unnamed: J1.B8, TP36.1
unnamed: J15.A8, TP29.1
unnamed: J15.B8, TP30.1
unnamed: J16.1, U10.17
unnamed: J16.2, U10.18
unnamed: J16.3, U10.19
unnamed: J16.5, U10.20
unnamed: J16.7, U10.21
unnamed: J16.8, U10.22
unnamed: Q1.4, Q15.4, R55.2, TP27.1
unnamed: Q2.3, U3.2
unnamed: Q4.4, R18.1, R22.2, TP11.1
unnamed: Q4.5, Q4.6, Q4.7, Q4.8, Q6.5, Q6.6, Q6.7, Q6.8, R26.2, TP12.1
unnamed: Q6.4, Q7.3, R27.2, R29.1, TP14.1
unnamed: Q7.1, R30.2
unnamed: Q9.4, R38.1
unnamed: Q11.4, R54.2
unnamed: Q5.1, Q5.2, Q5.3, Q13.1, Q13.2, Q13.3, R96.2, R98.2
unnamed: Q14.2, R58.1, R59.2, U1.18
unnamed: Q16.1, Q16.2, Q16.3, Q17.1, Q17.2, Q17.3, R69.1, TP34.1
unnamed: Q16.4, Q17.4, R69.2, R70.2
unnamed: Q18.1, Q18.2, Q18.3, Q19.1, Q19.2, Q19.3, R81.1, TP43.1
unnamed: Q18.4, Q19.4, R81.2, R82.2
unnamed: Q20.1, Q21.3, R83.1
unnamed: Q23.1, Q23.2, Q23.3, Q24.1, Q24.2, Q24.3, Q26.1, Q26.2, Q26.3, Q27.1, Q27.2, Q27.3, R85.1, TP45.1
unnamed: Q23.4, Q24.4, Q25.3, Q26.4, Q27.4, R85.2
unnamed: Q28.3, U16.3
unnamed: Q29.1, R101.1, U12.19
unnamed: Q29.2, R43.2
unnamed: Q30.1, R115.1, U11.9
unnamed: Q30.2, R114.2
unnamed: Q32.3, R87.1
unnamed: R17.1, U2.8
unnamed: R19.1, R20.1, U4.24
unnamed: R22.1, U4.31
unnamed: R24.1, U4.30
unnamed: R24.2, TP13.1
unnamed: R26.1, U4.26
unnamed: R27.1, U4.28
unnamed: R28.1, U4.27
unnamed: R31.1, U4.25
unnamed: R32.1, SW1.1, U4.16
unnamed: R33.2, U6.1
unnamed: R34.2, R35.2
unnamed: R38.2, U1.31
unnamed: R39.1, U1.29
unnamed: R42.1, U1.26
unnamed: R47.1, U1.20
unnamed: R48.1, U1.19
unnamed: R49.1, R53.2, U8.3
unnamed: R50.2, U8.4
unnamed: R54.1, U1.24
unnamed: R55.1, U1.21
unnamed: R61.2, U11.18
unnamed: R62.1, R63.1
unnamed: R65.2, TP65.1, U11.6
unnamed: R70.1, U11.16
unnamed: R71.1, TP64.1, U12.6
unnamed: R72.2, U11.12, U11.13
unnamed: R73.2, U12.13
unnamed: R74.2, U12.18
unnamed: R82.1, U12.20
unnamed: R90.2, U5.6
unnamed: R92.2, U5.4
unnamed: R93.2, TP52.1, U5.13
unnamed: R94.2, TP53.1, U5.14
unnamed: R99.1, R100.2, R123.1, U5.11
unnamed: R103.1, R104.2, U15.3
unnamed: R105.2, U15.4
unnamed: R109.2, U13.2
unnamed: SW2.1, U4.17
unnamed: TH2.2, U4.13
unnamed: TH3.2, U4.12
unnamed: TH4.2, U4.11
unnamed: TH5.2, U4.10
unnamed: TP25.1, U1.14
unnamed: TP26.1, U1.15
unnamed: TP33.1, U11.15
unnamed: TP38.1, U7.3
unnamed: TP39.1, U12.17
unnamed: TP40.1, U12.11
unnamed: TP41.1, U12.12
unnamed: TP42.1, U12.14
unnamed: TP61.1, U7.7
unnamed: TP62.1, U9.3
unnamed: TP63.1, U9.7
unnamed: TP67.1, U10.29
unnamed: TP68.1, U10.30
unnamed: TP69.1, U10.31
unnamed: TP70.1, U10.37
