shadowpho/SmartBattery/(commit log)

2020-12-10 Initial CI
    [Battery_Protection.sch, SmartBattery.kicad_pcb, SmartBattery.sch]
2020-12-12 added some more protection connection
    [SmartBattery.sch]
2020-12-14 Almost done with battery protection.
    [SmartBattery.sch]
2020-12-16 Battery protection sch done. Assigned 99% of footprints. Layout is gonna be rough.
    [Battery_Protection.sch, SmartBattery.sch]
2020-12-17 Finished battery protection, starting charger page
    [Battery_Protection.sch, Charger.sch, SmartBattery.sch]
2020-12-18 Added capacitors, inductors to charger page. Fixed capacitor sizes.
    [Battery_Protection.sch, Charger.sch, SmartBattery.kicad_pcb, SmartBattery.sch]
2020-12-19 Added bunch of cap to charger, made footprint for diode + fuse
    [Battery_Protection.sch, Charger.sch, SmartBattery.kicad_pcb]
2020-12-20 Finished Charger section, assigned all footprints. Next is output and then peripherals.
    [Charger.sch, SmartBattery.kicad_pcb]
2020-12-21 Adding lots of changes. Started output Stage
    [Battery_Protection.sch, Charger.sch, OutputStage.sch, Peripheral_3p3v.sch, SmartBattery.kicad_pcb, SmartBattery.sch]
2020-12-25 Lots of changes for MFG: parts info
    [Battery_Protection.sch, Charger.sch, Cost_Seeed.csv, OutputStage.sch, Peripheral_3p3v.sch, SmartBattery.csv, SmartBattery.kicad_pcb, SmartBattery.sch]
2020-12-30 Switching over to jlpcb
    [Battery_Protection.sch, Charger.sch, Cost_JLC.xlsx, Cost_Seeed.csv, LMR14030SDDAR.STEP, MCU.sch, OutputStage.sch, Peripheral_3p3v.sch]
2020-12-31 Replaced old charger to support JLC assembly. Very close now!
    [Battery_Protection.sch, Charger.sch, Cost_JLC.xlsx, MCU.sch, OutputStage.sch, Peripheral_3p3v.sch, SmartBattery.kicad_pcb, SmartBattery.sch]
2021-01-04 Both type-c ports are done! Only outputstage left.
    [Battery_Protection.sch, Charger.sch, MCU.sch, OutputStage.sch, Peripheral_3p3v.sch, SmartBattery.kicad_pcb, SmartBattery.sch, TPS2511DGNR.step]
2021-01-05 Added final touches to barrel jack and feedforward.
    Need to finish output stage, then add screw terminals.
    [Barrel_Jack_Input.sch, Battery_Protection.sch, Charger.sch, Cost_JLC2.xlsx, MCU.sch, OutputStage.sch, Peripheral_3p3v.sch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]
2021-01-11 Type_A_implemented. Sch "locked". PCB Layout started.
    *Changelog:
    *Type-a switching regulator (TBD -- need to check inductor,caps, stability. Maybe check both peripherial inductors?)
    *Type-A load switch + connector + esd
    *started layout..
    *found out that my footprint for n fet is wrong. Fixing now, need to replace all of those.
    [Barrel_Jack_Input.sch, Battery_Protection.sch, Charger.sch, DESIGN1.DSN, Design1.opj, MCU.sch, OutputStage.sch, Output_TYPEA1.sch]
2021-01-15 Much layout. Wow
    [Battery_Protection.sch, Charger.sch, OutputStage.sch, SmartBattery.kicad_pcb, SmartBattery.sch]
2021-01-17 Layout placed type-c + barrel jack
    [Barrel_Jack_Input.sch, Battery_Protection.sch, Charger.sch, JACK-C-PC-10A-RA_R_.step, MCU.sch, OutputStage.sch, SmartBattery.kicad_pcb, SmartBattery.sch]
2021-01-21 Much layout wow.
    [Charger.sch, MCU.sch, OutputStage.sch, Output_TYPEA1.sch, Peripheral_3p3v.sch, SmartBattery.kicad_pcb, SmartBattery.sch, Type_C_Output.sch]
2021-01-26 Almost connected MCU + ESP32 added leds addedd uart usb cleaned up type-c I/O -- STILL NEED TO level shift I2C
    [Charger.sch, MCU.sch, OutputStage.sch, Peripheral_3p3v.sch, SmartBattery.kicad_pcb, SmartBattery.sch, Type_C_Output.sch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]
2021-01-27 lots of GPIO connectivity changes. fixed no PD on input fixed CH340G leakage. can otherwise power from GPIO. added fet for powering VCONN from 3v/5v NEED TO ADD OVERCURRENT
    [Barrel_Jack_Input.sch, Cost_JLC3.xlsx, DM3AT-SF-PEJM5.step, MCU.sch, OutputStage.sch, SmartBattery.kicad_pcb, SmartBattery.sch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]
2021-01-29 Modified connections, added current limit
    [MCU.sch, OutputStage.sch, SmartBattery.kicad_pcb, SmartBattery.sch, Type_C_Output.sch]
